xioTechnologies/x-IMU3-SA-AX/PCB/Project Outputs for x-IMU3-SA-AX/ExportSTEP/x-IMU3-SA-AX.step

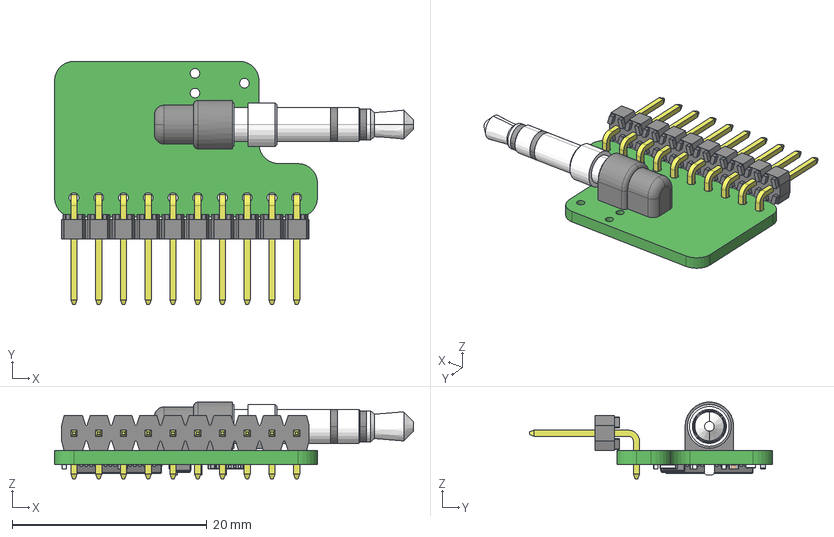
[picture p1: CAD file, 2025-01-20]
PCB/Project Outputs for x-IMU3-SA-AX/ExportSTEP/x-IMU3-SA-AX.step
36.9 x 25.0 x 7.90 mm
ESC 2x2.5mm
Extruded
QFN-64
YC248
User Library-R SMD 0402_0402 BODY x 3
User Library-R SMD 0402_0402 PAD x 6
User Library-R SMD 0402_0402 OPIS x 3
Molex 90121-0770
SP-3533-02
Capacitor 0402 x 10
