xioTechnologies/x-IMU3-SA-AX/PCB/Project Outputs for x-IMU3-SA-AX/x-io.PDF

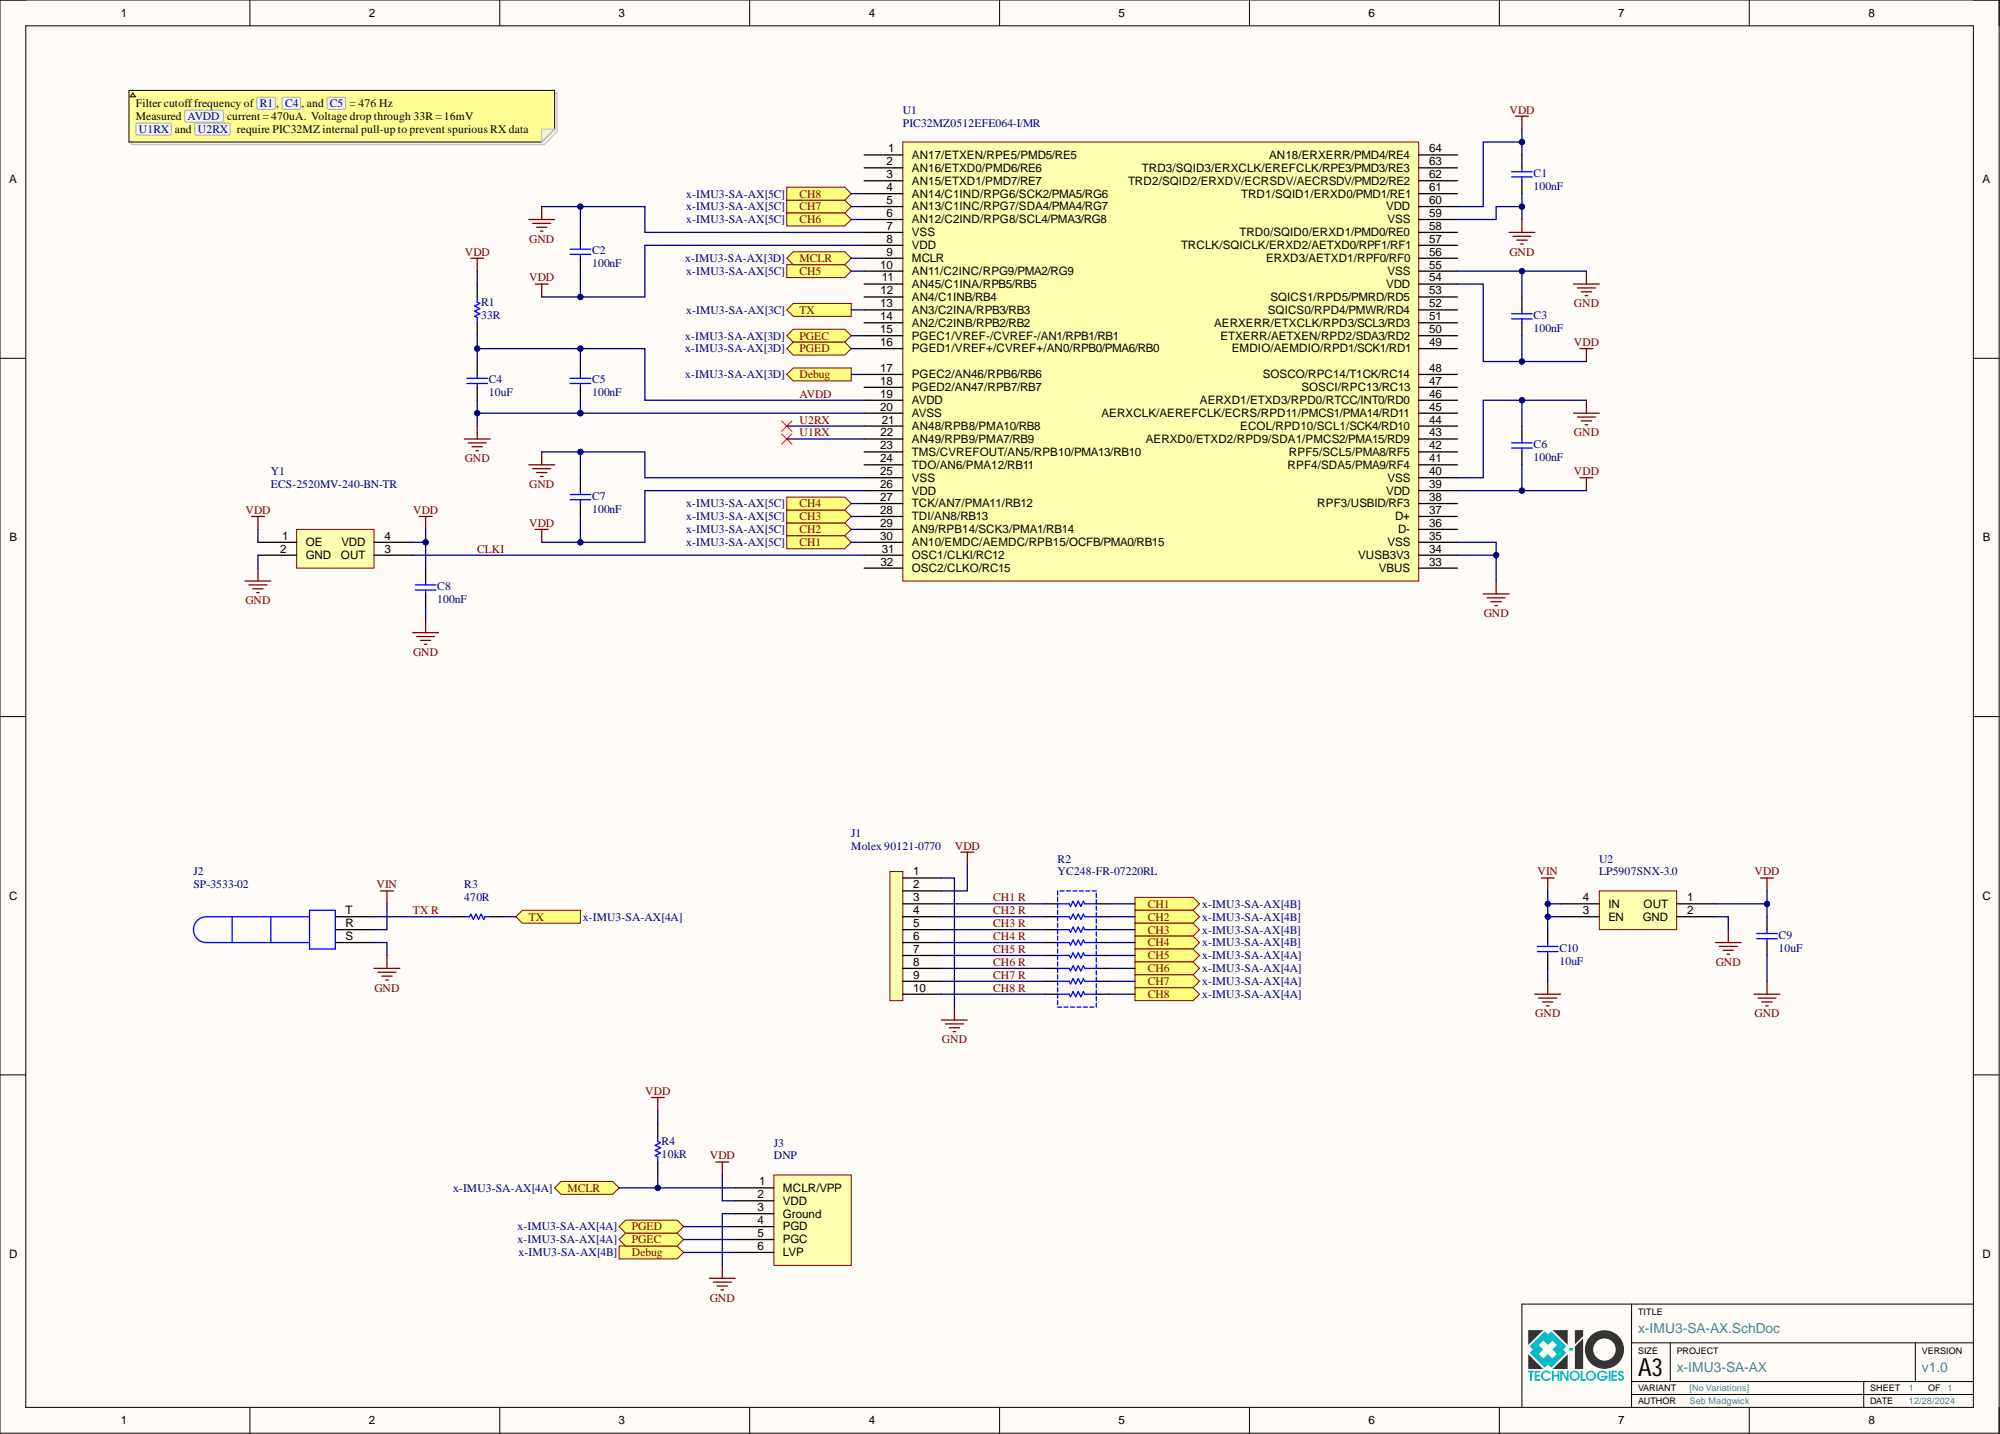
[picture p2: page 1]

Filter cutoff frequency of R1 , C4 , and C5 = 476 Hz
Measured AVDD current = 470uA. Voltage drop through 33R = 16mV
U1RX and U2RX require PIC32MZ internal pull-up to prevent spurious RX data

Ground 3
PGD 4 PGC 5 LVP 6

TITLE x-IMU3-SA-AX.SchDoc

SIZE A3 | PROJECT x-IMU3-SA-AX | VERSION v1.0

VARIANT [No Variations] | SHEET 1 OF 1
AUTHOR Seb Madgwick | DATE 12/28/2024

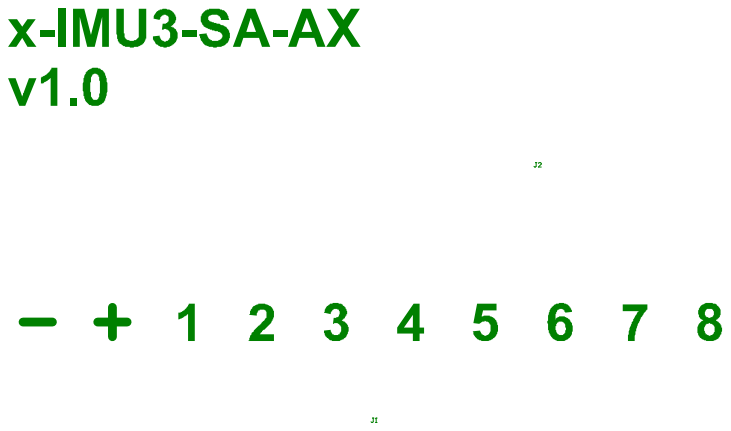
[picture p3: page 2]

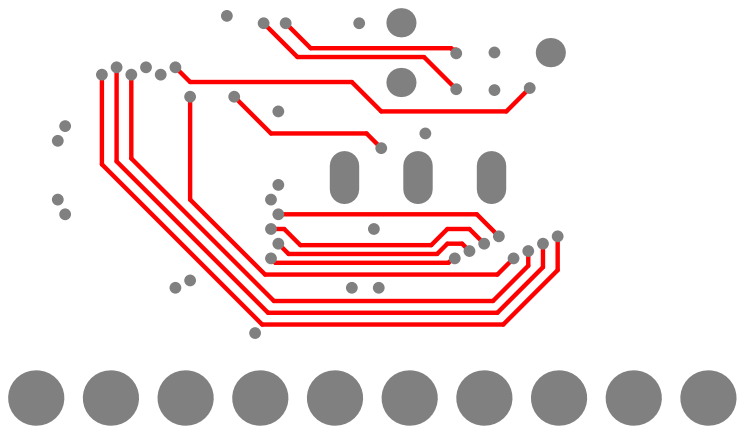
[picture p4: page 4]

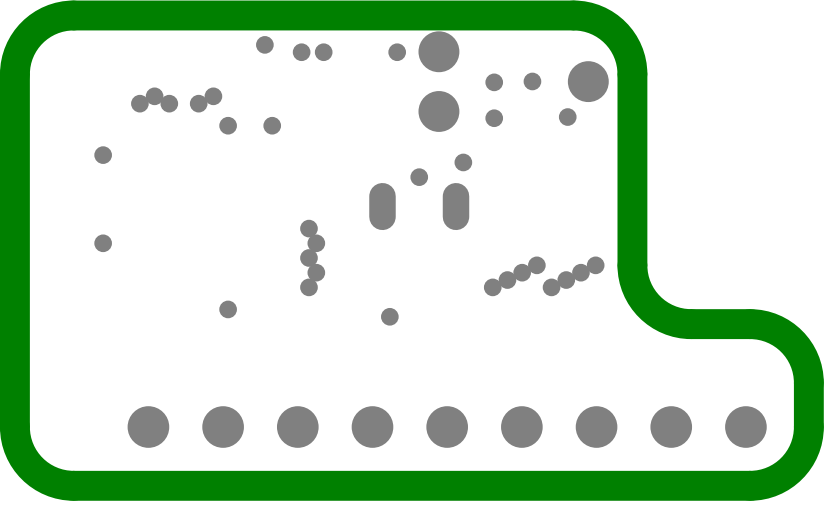
[picture p5: page 5]

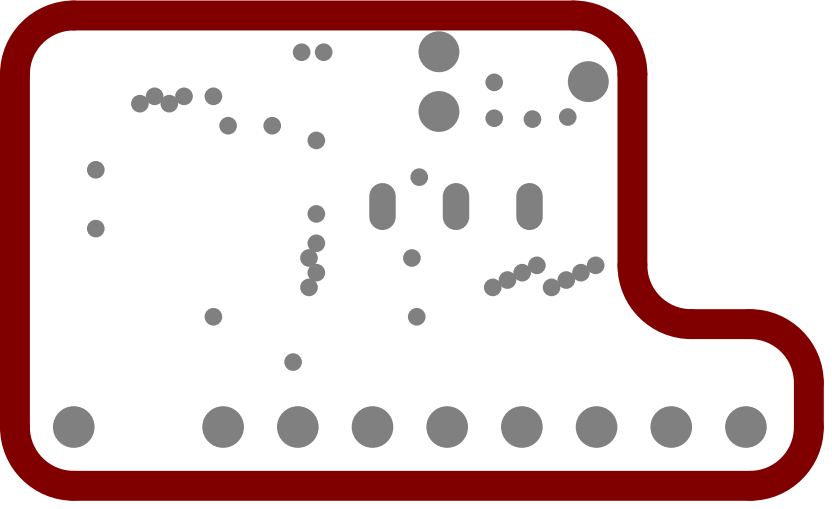
[picture p6: page 6]

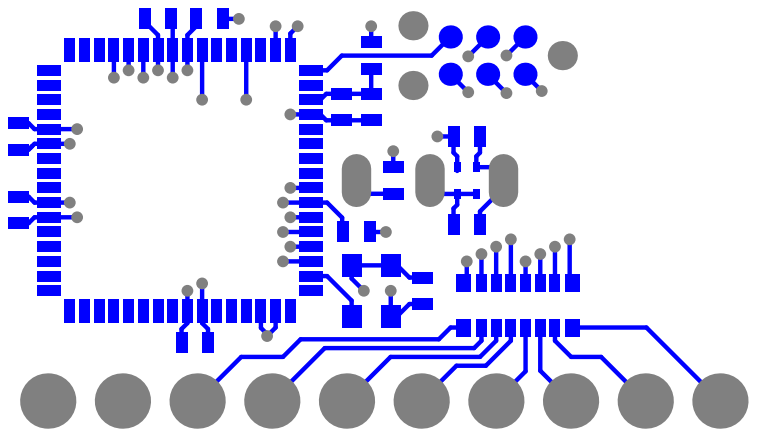
[picture p7: page 7]

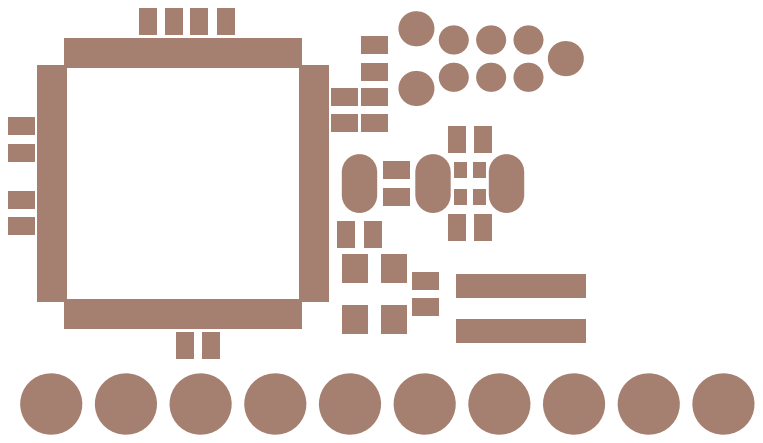
[picture p8: page 8]

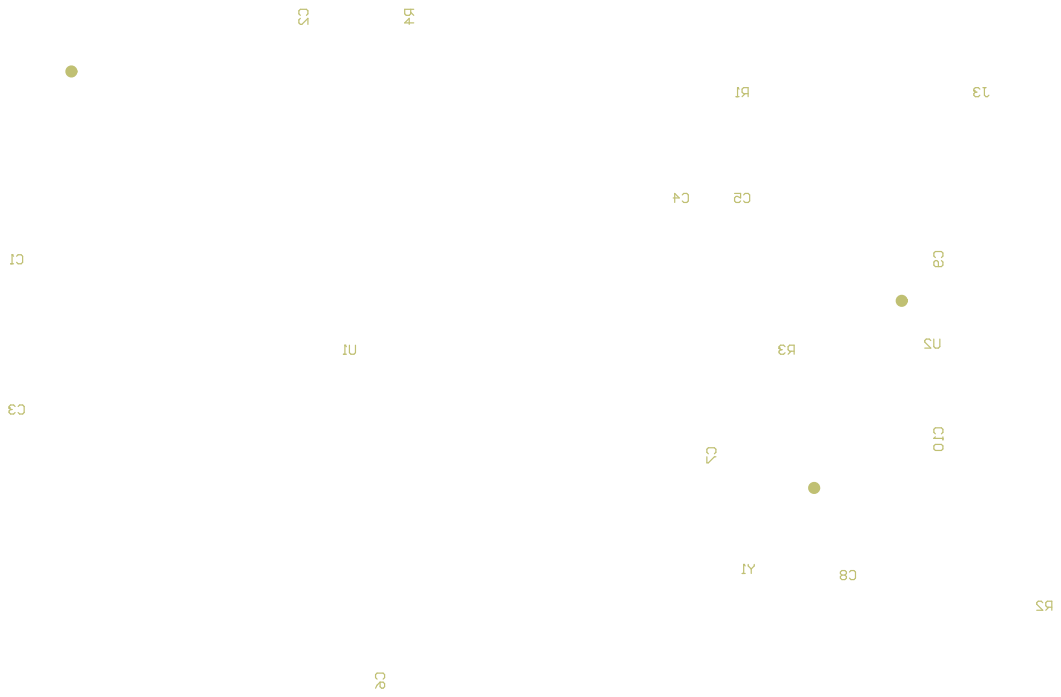
[picture p9: page 9]

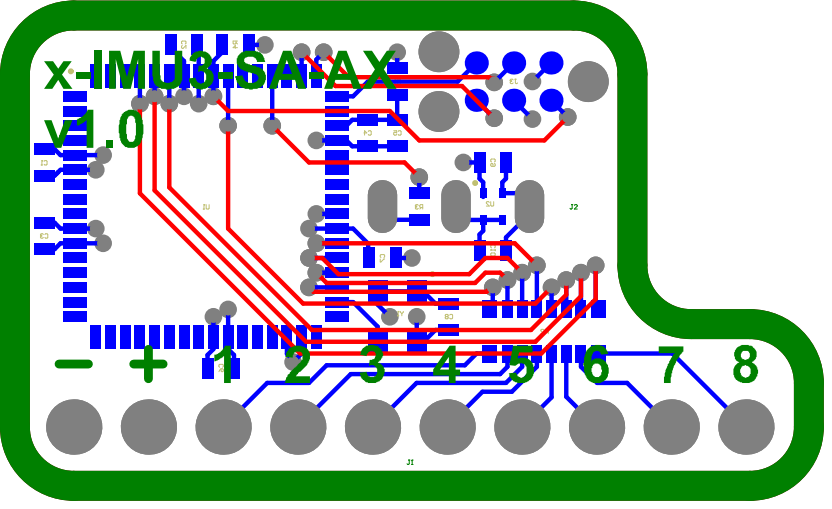
[picture p10: page 12]

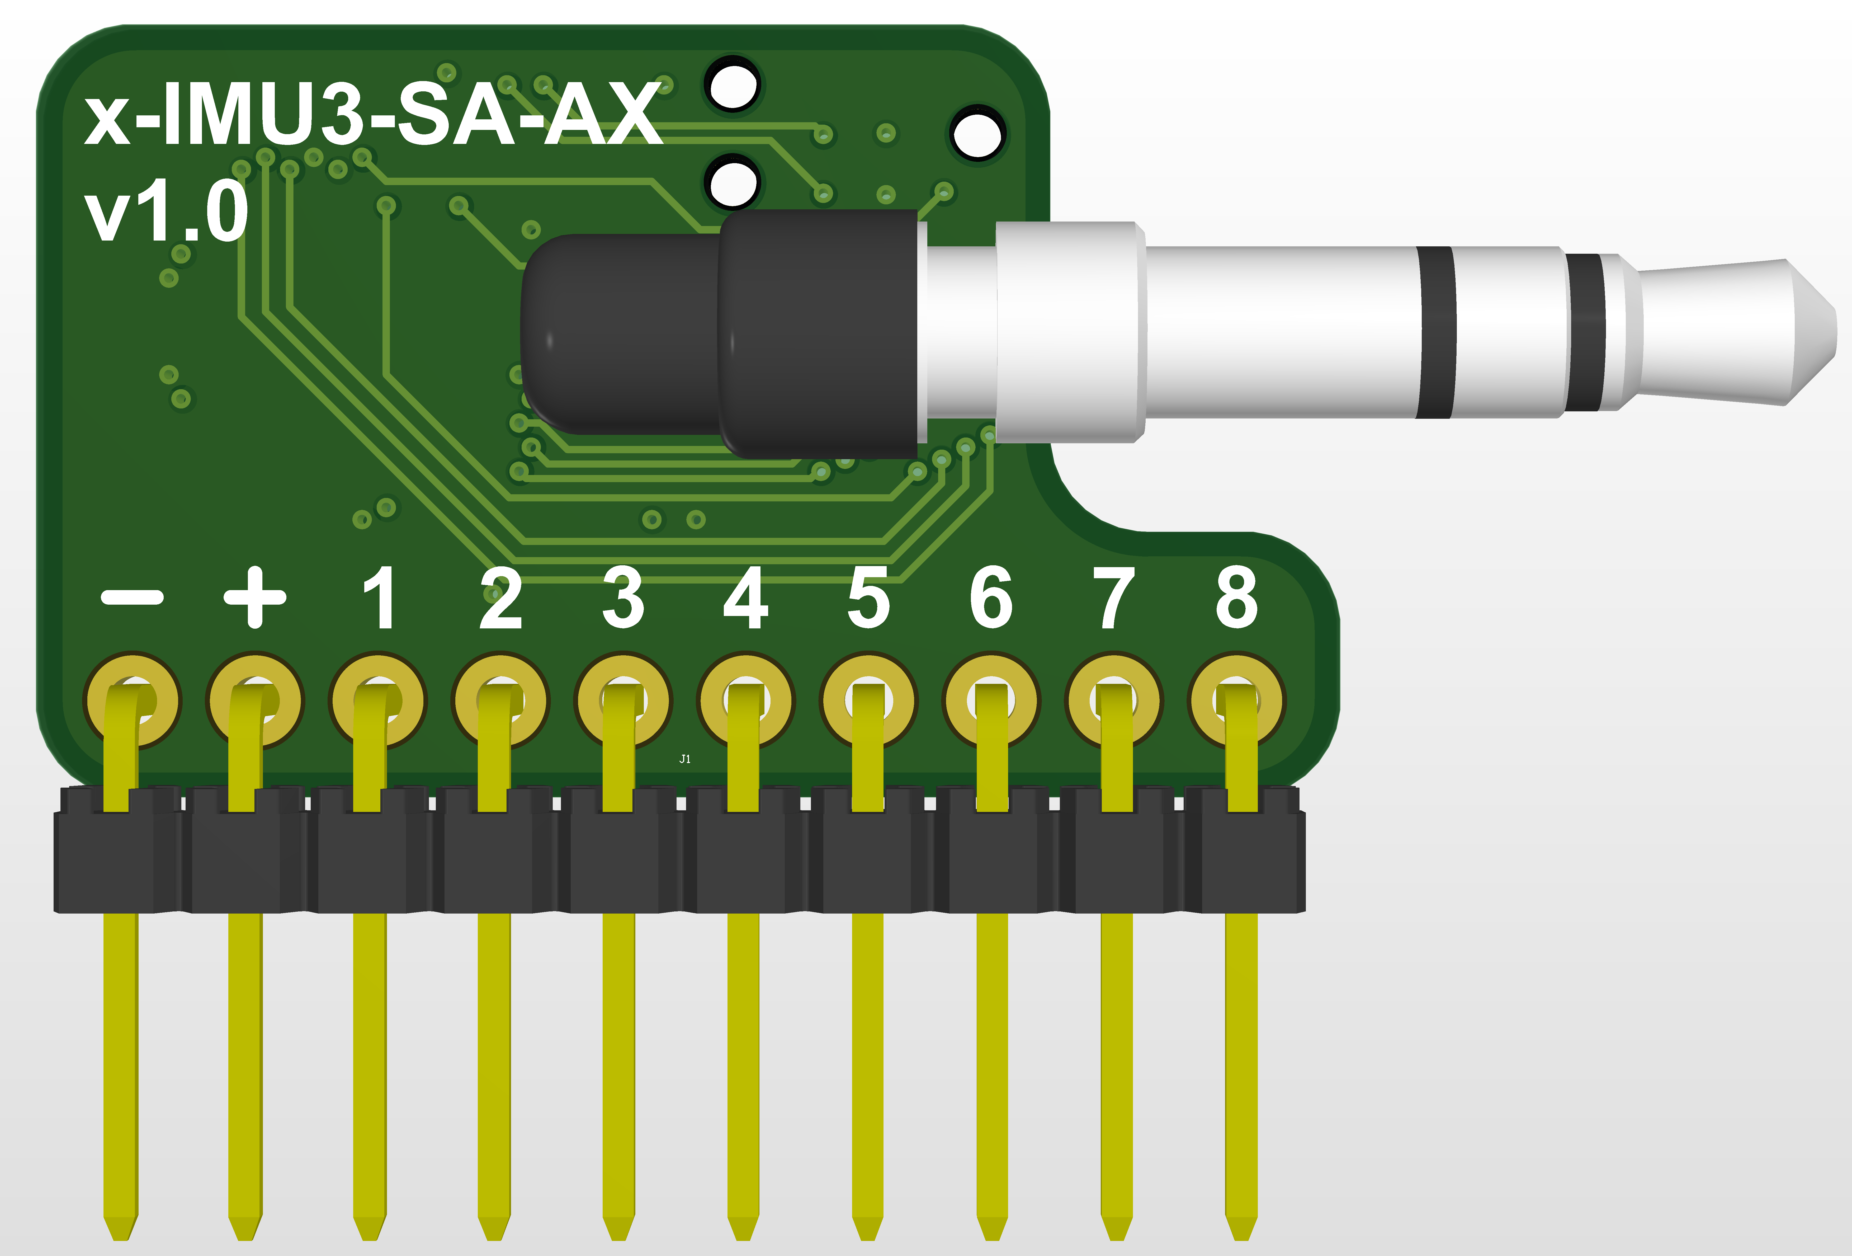
[picture p11: page 13]

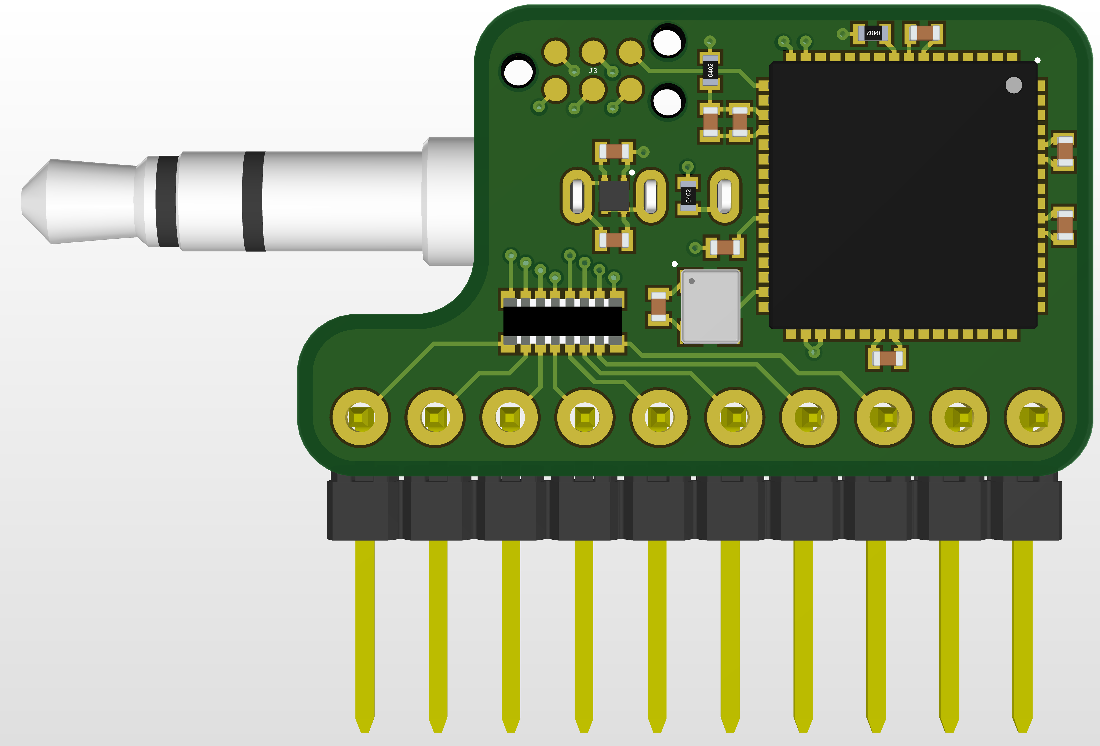
[picture p12: page 14]

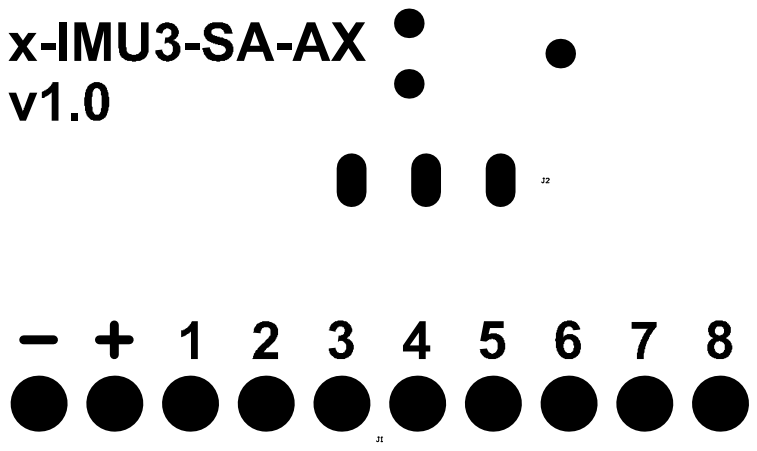
[picture p13: page 16]

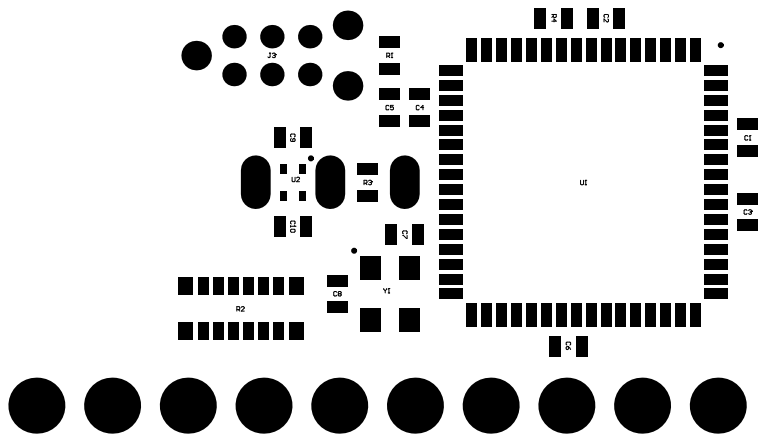
[picture p14: page 17]

Designator | Quantity | Comment | Footprint
C1, C2, C3, C5, C6, C7, C8 | 7 | 100nF | Capacitor 0402
C4, C9, C10 | 3 | 10uF | Capacitor 0402
J1 | 1 | Molex 90121-0770 | Molex 90121-0770
J2 | 1 | SP-3533-02 | SP-3533-02
J3 | 1 | DNP | Tag Connect No Legs
R1 | 1 | 33R | Resistor 0402
R2 | 1 | YC248-FR-07220RL | YC248
R3 | 1 | 470R | Resistor 0402
R4 | 1 | 10kR | Resistor 0402
U1 | 1 | PIC32MZ0512EFE064-I/MR | QFN-64
U2 | 1 | LP5907SNX-3.0 | X2SON
Y1 | 1 | ECS-2520MV-240-BN-TR | ECS 2x2.5mm
