xioTechnologies/x-IMU3-SA-AX/(list of files, drawings)

Other design files:
PCB/x-IMU3-SA-AX.PcbDoc
PCB/x-IMU3-SA-AX.PrjPcb
PCB/x-IMU3-SA-AX.SchDoc
